NyxFoundation/FoldNTT/docs/README.md

# docs/ — paper materials

Write-up of the two verified inventions (`../verification/`), building
toward a submission. Produced phase-by-phase by an autonomous loop; every
claim traces to a CI-reproducible script.

| File | Contents |
|---|---|
| `paper-plan.md` | phase tracker + remaining-before-submission list |
| `related-work.md` | novelty sweep; adjusted claims C1–C3 |
| `lemmas.md` | the 4 lemmas with proofs + machine-check cross-refs |
| `evaluation.md` | system-sim results + synthesis cost table (PnR TODO) |
| `generalization.md` | Proth-prime generator; Falcon + Kyber instances |
| `algorithm-level.md` | where the ideas apply outside hardware; prime-selection guidance (with `generator/prime_scout.py`) |
| `scaling.md` | measured lane-array scaling: iso-chip parallelism, clock cost, the ceiling (with `fpga/scale_sweep.sh`) |
| `paper/paper.md` | full manuscript draft (section TODOs + refs inline) |
| `venue-assessment.md` | where-to-submit / what-level analysis |

Status: draft complete; open items in `paper-plan.md` → "Remaining before
submission" (background prose, bibliography, one prior-work diff, whole-core
PnR, artifact DOI, venue choice).
