NyxFoundation/FoldNTT/fpga/README.md

# Post-route Fmax: open flow (no Vivado)

Routed Fmax for the reference vs proposed multiplier and butterfly on
Artix-7 xc7a100t, using openXC7's `nextpnr-xilinx`. No Vivado, no
multi-GB AMD download.

## Tools: one command via the repo flake

```sh
nix develop        # from the repo root; sets NP + CHIPDB (xc7a100t) + yosys
fpga/fmax.sh          # then the scripts run with no arguments
fpga/fmax_core.sh
```

The repo `flake.nix` pins openXC7 tag `0.8.2` (HEAD's flake currently
fails to evaluate: `nextpnr-xilinx` is missing from its nixpkgs binding; `0.8.2`
has a self-consistent `flake.lock`) and wires `NP`/`CHIPDB`/`YOSYS` into the
devShell. First entry builds the Artix-7 chipdb from prjxray-db (~10-20 min,
heavy pypy pass); it is then cached in the nix store.

Manual (no flake) equivalent:

```sh
nix build github:openXC7/toolchain-nix/0.8.2#packages.x86_64-linux.nextpnr-xilinx
nix build github:openXC7/toolchain-nix/0.8.2#packages.x86_64-linux.nextpnr-xilinx-chipdb.artix7
export NP=<result-nextpnr>/bin/nextpnr-xilinx CHIPDB=<result-chipdb>/xc7a100tcsg324.bin YOSYS=yosys
```

## Method

Each module is register-wrapped (`wrap.py`): every DUT input is driven
from an internal shift register and every output is registered then
XOR-reduced, so the only I/O is `clk` + `serial_in` + `serial_out`. This
(a) makes the timed path a true register-to-register critical path, and
(b) avoids the wide-module I/O-placement failures nextpnr hits when 40-80
ports must be pinned. Reported = best of 3 placer seeds.

## Result (interpretation in ../../docs/evaluation.md)

| module | Fmax (xc7a100t) |
|---|---|
| `modular_mul` (Barrett, 3 DSP) | ~233 MHz |
| `modular_mul_kred` (K-RED, 1 DSP) | ~230 MHz |
| `compact_bf` (reference, INTT-buggy) | ~164 MHz |
| `compact_bf_v2` (K-RED, INTT-correct) | ~122 MHz |

K-RED is Fmax-neutral at the multiplier (3→1 DSP for free), and the
butterfly trades ~26% clock for the DSP/memory savings, partly the cost of
correctness: the reference omits the §3 halving. A pipelined K-RED/fold
recovers most of it at +1 latency.

## Whole-core Fmax (`fmax_core.sh`)

The same flow on the whole core (`top_poly_mul` vs `top_poly_mul_v2`, linked
against `fullcore/fsm_recon.v` to elaborate; static timing needs only the
netlist) gives ~137 vs ~136 MHz: the butterfly's −26% dilutes to ~1% at
the core, because the memory system / address generators / networks / FSM
(identical in both) dominate the critical path.

## Files
| File | Role |
|---|---|
| `fmax.sh` | per-module Fmax comparison (best of 3 seeds) |
| `fmax_core.sh` | whole-core Fmax (reference vs proposed top) |
| `wrap.py` | register-wrapper generator (reduces a module to clk + 2 pins) |
