NyxFoundation/FoldNTT/docs/evaluation.md

# Evaluation (Phase 3–4)

## §sim: system-level RTL simulation (DONE)

`verification/fullcore/run_stream.py` drives the invented RTL (the
register-level hardware source code:
`compact_bf_v2` + `modular_mul_kred` + `tf_rom_fold`) through a full N=1024
NTT and INTT under iverilog. On every tested vector, the RTL `NTT(x)` equals
the reference `DIT_NR_NTT` on the real twiddle table (the precomputed
constants the transform multiplies by), and
`INTT(NTT(x)) == x` exactly. The issue-#7 halving fix and the 9⁻¹-scaled
folded ROM therefore compose into a correct transform at the system level,
not merely per butterfly (the transform's small multiply-and-add step).

This closes the gap the module proofs leave. fv_bf_v2 proves the butterfly
matches the spec for every input; `run_stream.py` shows that the specced
modules, sequenced by a controller and fed by the folded ROM, realize the
whole transform on real gates (iverilog).

The banked memory system is covered too: the released `fsm.v` is empty
(upstream #4), so `verification/fullcore/fsm_recon.v` reconstructs a
controller from the shipped datapath's timing, and `run_sim.py` drives the
whole `top_poly_mul` (reference and v2) through NTT then INTT on five
vectors. The reference core returns `NTT(x)` exactly and `INTT(NTT(x)) =
2¹⁰·x` (issue #7 at full-core RTL); the v2 core round-trips exactly; both
take 5290 cycles per 1024-point transform, data-independent. The controller
is consistent with the released datapath but is not the authors' original.
See `verification/fullcore/README.md`.

## §synth: synthesis cost (DONE, generic; PnR pending)

All numbers come from `yosys` generic synthesis (`synth -flatten -noabc`),
reproducible via `kred-butterfly/cost_report.ys` and the ROM comparison. Cell
counts are technology-independent gate counts, not LUTs (the FPGA's
logic cells).

| Block | reference | proposed | Δ |
|---|---|---|---|
| modular multiplier | `modular_mul.v` 2176 cells, 101 FF, **3 mults** | `modular_mul_kred.v` 1724 cells, 74 FF, **1 mult** | −21% cells, −27% FF, −67% mults |
| butterfly | `compact_bf.v` 2820 cells, 297 FF, 3 mults | `compact_bf_v2.v` 2549 cells, 270 FF, 1 mult | −10% cells (**and INTT-correct**) |
| twiddle ROM | `tf_ROM.v` 7828 cells, 14322 stored bits | `tf_rom_fold.v` 1611 cells, 7168 stored bits | −79% cells, −50% bits |

These generic counts are directionally useful, but they overstate the FPGA
benefit for the ROM, which maps to distributed LUT-RAM rather than gates.
For the ROM, the paper relies on the FPGA-primitive numbers below, not the
generic counts.

### FPGA primitives (open flow: `yosys synth_xilinx`, xc7 target)

The generic gate counts overstate the FPGA story in two ways; mapping to
real 7-series primitives resolves both. Per module, flattened
(reproduce: `nix shell nixpkgs#yosys --command fpga/fpga_cost.sh`):

| module | LUT | FF | **DSP48** | CARRY4 |
|---|---|---|---|---|
| `modular_mul` (Barrett) | 29 | 101 | **3** | 8 |
| `modular_mul_kred` | 83 | 74 | **1** | 14 |
| `compact_bf` (ref) | 158 | 297 | **3** | 24 |
| `compact_bf_v2` | 231 | 270 | **1** | 46 |
| `tf_ROM` | 241 | 14 | 0 | 0 |
| `tf_rom_fold` | 192 | 15 | 0 | 18 |

Reading, and why the per-FPGA numbers matter:

1. DSP (the FPGA's dedicated multiplier blocks) 3 → 1 holds on real
   primitives: −67% DSP per butterfly and −27% FF (register cells)
   on the multiplier. NTT accelerators are almost always DSP-bound, since
   many parallel butterflies compete for the scarce DSP blocks. This is the
   saving that matters, and it scales ×d.
2. K-RED trades DSPs for LUT/carry logic. The multiplier's LUTs go
   29 → 83, the butterfly's 158 → 231; the shift-add folds are LUT+CARRY4.
   On a LUT-bound design the trade could be neutral-to-negative; on the
   usual DSP-bound design it is a clear win. We report both directions.
3. The ROM's −79% was generic gates, not FPGA. Mapped to primitives, the
   ROM stays in distributed LUT-RAM (yosys does not infer BRAM — an
   on-chip memory block — for
   1023×14 here), so `tf_rom_fold` is only −20% LUT (241 → 192), with
   fold7 adding CARRY4. The defensible ROM claim is the −50% stored bits,
   which converts to a BRAM saving only when the table is large enough to
   be BRAM-mapped (bigger N, or a forced `ram_style="block"`); at Falcon's
   N=1024 as distributed ROM the LUT win is real but small. The paper is
   corrected accordingly.

### Whole-core area (open flow, `fpga/fpga_cost_core.sh`)

Synthesizing the whole core (one butterfly + two conflict-free banks + the
twiddle ROM + address generators + the reconstructed FSM), reference
`top_poly_mul` vs proposed `top_poly_mul_v2`, on 7-series primitives:

| core | LUT | FF | **DSP48** | RAMB18 | CARRY4 |
|---|---|---|---|---|---|
| reference | 784 | 580 | **3** | 2 | 106 |
| proposed | 819 | 500 | **1** | 2 | 138 |

The released `fsm.v` is empty, so the core is linked against
`fullcore/fsm_recon.v`, the reconstructed controller that `run_sim.py`
validates end-to-end (§sim); datapath leaf modules carry `keep` so DCE
doesn't strip the un-observed banks/mult/ROM, matching the RTL's
`DONT_TOUCH`.

Whole-core reading:

- DSP48 3 → 1: with a single butterfly, the per-butterfly saving is the
  whole-core saving, and with `d` parallel butterflies it scales ×d. This
  confirms the headline at the core level.
- FF −14% (582 → 502): the K-RED multiplier has fewer pipeline
  registers than Barrett (580→502 with the reconstructed FSM's pipe register).
- LUT +5% (784 → 824): the K-RED DSP→LUT trade (butterfly +73 LUT)
  slightly outweighs the folded ROM's LUT saving (−49) at the core level,
  diluted by the unchanged banks/AGU/FSM. Consistent with the per-module
  numbers.
- RAMB18 unchanged (2 = 2): the two RAMB18 are the two data banks. The
  twiddle ROM maps to distributed LUT-ROM in both cores, so the ψ-fold's
  −50% stored bits does not cut BRAM count at N=1024; it would only at a
  larger table or a forced block-RAM mapping. This confirms the ROM caveat
  above with a whole-core measurement.

### Timing proxy: logic depth (open flow, no PnR needed)

Fmax (the highest clock frequency the routed design sustains) needs PnR
(place and route: mapping the logic onto the chip's physical fabric), but
yosys' longest-topological-path (`ltp`) gives a
technology-mapped logic-depth proxy that already answers the paper's two
timing questions. Per module (post-`synth_xilinx`, LUT/carry levels):

| module | LTP (logic levels) |
|---|---|
| `modular_mul` (Barrett) | 17 |
| `modular_mul_kred` | 21 |
| `tf_ROM` | 7 |
| `tf_rom_fold` | 26 |

- K-RED vs Barrett (21 vs 17): the K-RED fold adder chains add ~4 levels
  of logic. But `modular_mul`'s DSP48 counts as ~1 level in this proxy while
  hiding a full multiply, so the comparison understates Barrett. Both units
  are latency-4 pipelined, so the per-stage path is what sets Fmax, and the
  K-RED stages are short adder chains. Directionally comparable; confirm with
  PnR.
- fold7 on the ROM path (26 vs 7): the derived-half read path is
  materially deeper than a plain ROM lookup. The ψ-fold's real cost is
  combinational depth on the upper-half read, not area. This is the risk the
  ROM change carries, and we already acted on it (below).

**Depth-driven redesign of fold7.** This analysis itself drove an RSI step.
The first fold7 used three chained conditional subtractions (−4q, −2q, −q),
LTP 31. Since `7x ∈ [0, 7q)`, we replaced them with six parallel constant
comparators that select `m·q` from precomputed multiples, followed by a
single subtraction: LTP 31 → 26, LUT 214 → 192, CARRY4 23 → 18, still
DSP-free. The new datapath was re-verified end-to-end: z3 (an automated theorem prover) `VERIFIED`, the
shipped-ROM equivalence miter (a circuit comparing the two
implementations output-for-output), the full-transform sim, and the mutation
sweep all pass. A pipelined fold7 (one extra register) would remove the
depth from the ROM read entirely at +1 latency; we keep the combinational
version to preserve the drop-in 1-cycle ROM interface, and flag the
depth/latency trade for PnR.

### Post-route Fmax (open flow, no Vivado): `fpga/fmax.sh`

Routed Fmax was obtained without Vivado, via openXC7's `nextpnr-xilinx`
(pin the working tag `github:openXC7/toolchain-nix/0.8.2`; HEAD's flake is
broken) with the artix7 chipdb, on xc7a100t. Each module is
register-wrapped (`fpga/wrap.py`: all inputs come from an internal shift
register, outputs are registered and XOR-reduced, so only clk + 2 pins are
I/O) to time the true register-to-register critical path; best of 3 placer
seeds:

| module | Fmax (xc7a100t, best of 3 seeds) |
|---|---|
| `modular_mul` (Barrett, 3 DSP) | 243 MHz |
| `modular_mul_kred` (K-RED, 1 DSP) | 232 MHz |
| `compact_bf` (reference — INTT-buggy) | 169 MHz |
| `compact_bf_v2` (K-RED, INTT-correct) | 123 MHz |

(Pinned toolchain: yosys 0.62 + openXC7 nextpnr-xilinx 0.8.2 via `nix
develop`; each seed's nextpnr log is archived under `fpga/reports/`.)

Reading; this is the number real PnR was needed for:

1. At the multiplier, K-RED costs about 4% Fmax vs Barrett (232 vs 243
   MHz, comparable to the seed spread). Dropping 3→1 DSP therefore costs
   little clock speed at the unit that matters for the DSP budget.
2. At the butterfly, the proposed core is slower (123 vs 169 MHz,
   −27%). Two plausible causes, not isolated by measurement: (a) the
   reference butterfly omits the per-stage `op21` halving (§3), so a
   correct reference would also pay for those gates. (b) The K-RED
   fold + fused-op21 logic lengthens the butterfly critical path vs a
   single DSP multiply.
3. Net: the ψ-fold/K-RED design trades DSP and twiddle storage for clock
   frequency at the butterfly. On a DSP- or memory-bound NTT accelerator
   that is the right trade; if the design is Fmax-bound, Barrett's DSP
   path is faster. We report the tradeoff, not a one-sided win.

**Whole-core Fmax** (`fpga/fmax_core.sh`, same RTL configuration as the
area measurement, with the validated reconstructed controller): reference
`top_poly_mul` 143.1 MHz vs proposed `top_poly_mul_v2` 137.5 MHz, best of
3 seeds (−4%). The seeds span 127–143 MHz (reference) and 130–138 MHz
(proposed), medians 136 vs 134 MHz, so the difference is inside the
seed-to-seed spread: read it as "a few percent at most". The butterfly's
−27% does not propagate to the core, consistent with the conflict-free
memory system, address generators, operand networks and FSM, all identical
in both cores, setting the critical path. At the level that actually
ships, the redesign delivers 3→1 DSP, −14% FF, the INTT bug fix and half
the twiddle storage at a few percent of Fmax.

A pipelined K-RED / fold7 (one extra register each) would recover much of
the butterfly Fmax at +1–2 cycles latency; a concrete follow-up. Vendor
(Vivado) numbers would confirm these open-flow figures but are not required
for the conclusion. Whole-core area and Fmax are measured on the
reconstructed controller that `run_sim.py` validates (see fullcore/README).
