NyxFoundation/FoldNTT/(commit log)

2026-07-02 feat(yosys): RTL-level formal verification — the 8 categories beyond datapath proofs
    SymbiYosys/yosys suite proving, directly on the released Verilog (no
    transcription):
    1. Pipeline timing: modular_mul == (a*b) mod q at latency 4 (BMC +
    k-induction); compact_bf == the DIT/DIF butterfly at latency 6, both
    modes, verified COMPOSITIONALLY — leaf units are proven equivalent to
    behavioural models (fv_units, fv_modular_mul) and then abstracted, so
    the butterfly obligations close in seconds (assume-guarantee).
    2. Control FSM: blocked by the release (fsm.v empty) — recorded by audit.
    3. Memory-hazard static half: AGU/bank-map properties re-proven on the RTL.
    4. Reset (outputs clea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
    [abstract_units.v, audit.py, fv_agu.sv, fv_compact_bf.sv, fv_modular_mul.sv, fv_param_width.sv, fv_reset.sv, fv_units.sv]
2026-07-02 docs: refresh READMEs — CI badge, yosys suite summary, compositional naming
2026-07-02 feat(proposed): CFNTT-KRED — 1-multiplier, bug-fixed radix-2 butterfly
    Recursive view->implement->verify loop over the reference design yields a
    drop-in replacement (same ports, delay fabric, latencies):
    - modular_mul_kred.v: q = 3*2^12+1 is Proth, so 3*2^12 == -1 (mod q) and
    the 28-bit product reduces by two shift-add K-RED folds + one conditional
    subtraction — 1 hardware multiplier instead of Barrett's 3 (K-RED per
    Longa & Naehrig 2016, known in software for this q; the verified hardware
    fusion into CFNTT is the contribution).
    - The unit returns 9ab mod q; the ROM stores 9^-1-scaled twiddles so every
    butterfly multiply is exact. The INTT twiddle is derived from the SAME
    R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
    [abstract_units_v2.v, fv_bf_v2.sv, fv_kred.sv, kred_math.py]
2026-07-02 feat(proposed): compositional fv_kred (fold-spec golden) + docs
    The %-golden miter (RTL Barrett-style re-verification against a 32-bit
    divider) did not converge in the solver; restructured to the established
    compositional chain — sby proves RTL == the K-RED fold spec (structural,
    seconds, k-induction closes too), verify_kred.py's z3 proof pins the fold
    == 9c mod q over the full domain. Mutation probe re-run: a nudged fold
    constant in the RTL is caught with a counterexample.
2026-07-03 feat(proposed): psi-fold twiddle ROM — half the words, found by visual review
    Reviewing the 3D architecture model showed the 1023-word twiddle ROM as
    the largest remaining block after the KRED redesign, next to two visual
    precedents (shift-add folds are ~free; op21-on-ROM derives variants from
    stored words). The bit-reversed negacyclic layout satisfies
    w_rom[512+j] == 7*w_rom[j] (mod q) for all j (psi = kesai = 7), and
    x7 = (x<<3)-x is shift-sub: tf_rom_fold.v stores 512 (9^-1-scaled) words
    and derives the rest with fold7 (three conditional subtractions, no
    multiplier), same interface/latency as tf_ROM.v. Recursive: a 256-word
    ROM needs at most fold7 x3 (validated e2e).
    Verified: fold r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
    [fv_rom_fold.sv, gen_rom_fold.py, rom_fold_math.py]
2026-07-03 test(proposed): thorough yosys verification sweep for both inventions
    New coverage, all green in a fresh end-to-end run (proposed/run_all.sh):
    - fv_reset_v2: async reset forces the v2 butterfly outputs to 0 from ANY
    symbolic state, with the REAL leaf units (BMC + k-induction).
    - fv_rom_fold strengthened: REN is now FREE — load cycles prove
    9*Q_new == Q_ref (mod q) at every legal address, idle cycles prove BOTH
    ROMs hold their outputs, so equivalence survives arbitrary stall
    patterns. The A=1023 divergence (shipped ROM holds, fold ROM wraps) is
    documented and excluded by an assumption itself proven in yosys/fv_agu
    (tf_address_generator never emits 1023). k-induction omitted w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
    [fv_reset_v2.sv, fv_rom_fold.sv]
2026-07-03 feat(fullcore): system-level RTL simulation of the inventions (phase 3-4)
    proposed/fullcore/run_stream.py drives the real compact_bf_v2 +
    modular_mul_kred + tf_rom_fold through a full N=1024 NTT+INTT under
    iverilog (pipelined issue, index delay-line collect, full ROM pre-read):
    NTT == reference DIT_NR_NTT, INTT(NTT(x)) == x EXACTLY — the issue-#7 fix
    and the folded ROM compose into a correct transform at the system level.
    Added to CI.
    Honest scope: cfntt_ref's exact banked-memory FSM is not reproduced (the
    released fsm.v is empty, upstream #4). fsm_recon.v + top_poly_mul_v2.v
    drive the actual banked datapath but the reconstructed schedule is not yet
    cycle-accurate (X's before pipeline fi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
    [fsm_recon.v, run_sim.py, run_stream.py, tb_fullcore.v, tb_stream.v, top_poly_mul_v2.v]
2026-07-03 docs+artifact: background prose, FPGA-primitive numbers (honest), Vivado guide, container
    Phase '1' (background) and '5' (artifact) of the paper plan:
    - paper.md §2: real Background prose (negacyclic NTT, DIT-NR/DIF-RN
    butterflies, psi, and CFNTT's conflict-free 2-bank mapping + shared ROM);
    removed the [TODO].
    - FPGA-primitive cost via the open flow (proposed/fpga_cost.sh, yosys
    synth_xilinx): DSP 3->1 per butterfly and -27% FF CONFIRMED on real
    primitives. Reported honestly: K-RED trades DSP for LUT/carry logic, and
    the ROM's generic -79% is only -11% LUT as distributed LUT-RAM (the
    defensible ROM claim is -50% stored bits, a BRAM win only when
    BRAM-mapped). Corrected abs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
2026-07-03 docs: Compact-FALCON diff from the FULL paper (user-provided PDF)
    Read the actual Compact-FALCON 2025 paper (docs/refs/, gitignored — IEEE
    copyright). Correction: it has NO twiddle-compression mechanism (the
    earlier attribution was a search-summary error). It stores twiddles in
    FULL (two FP64 ROMs; the NTT path reuses them) and its only twiddle
    reduction is skipping the trivial first/last FFT stage; NTT modular
    reduction is Barrett (K-RED only cited in background). Target xc7a100t
    @134MHz, Vivado 2022.2.
    Net effect: STRENGTHENS novelty — even the most recent (2025) Falcon NTT
    accelerator uses full twiddle ROMs + Barrett, so neither the psi-fold nor
    the K-RED retrofit overlaps it. Up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
2026-07-03 docs(paper): Fig.1 datapath, fold7 pseudocode, positioning table
    - Sec 4: ASCII datapath figure of compact_bf_v2 (1 mult, the two op21
    bug-fix gates highlighted).
    - Sec 4.2: fold7 rewritten to the parallel-reduction pseudocode (6 parallel
    comparators + 1 subtraction), replacing the stale 3-chained-subtract text.
    - Sec 7: FPGA-primitive table updated to the redesigned fold7 (LUT 214->192)
    with a logic-depth column, and a NEW positioning table vs CFNTT and
    Compact-FALCON — both use Barrett + full twiddle ROMs, so neither of our
    contributions overlaps them. Honest framing: a Pareto move on DSP +
    twiddle-memory at equal function on a verified, bug-fixed drop-in; no
    head-to-head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
2026-07-03 ci: replace flaky setup-oss-cad-suite with retrying tarball fetch
    The YosysHQ/setup-oss-cad-suite@v3 action intermittently failed fetching
    its release tarball, flaking docs-only pushes (verify job stayed green, but
    yosys-formal went red on infra, not on our code — locally run_all.sh is
    fully green). Resolve the latest release tag via the GitHub API and fetch
    the tarball with curl --retry (5x, --retry-all-errors), source its
    environment for both the yosys/run_all.sh and proposed/run_all.sh steps.
2026-07-03 ci: don't source oss-cad-suite/environment (it clobbered uv's python)
    The retrying tarball install fixed the setup flake, but sourcing
    oss-cad-suite/environment set LD_LIBRARY_PATH to its bundled libs, which
    hid uv's managed libpython3.11.so.1.0 -> proposed/run_all.sh's 'uv run'
    died with exit 127. oss-cad-suite's bin/ launchers are self-wrapping, so
    adding bin to PATH (already done via GITHUB_PATH) is enough for yosys/sby/
    yices without the environment munging that breaks uv.
2026-07-03 docs: honest venue assessment + submission strategy
    Candid read: the technical primitives (K-RED, half-twiddle-ROM) are mostly
    known art; the real edge is functional verification of a published
    accelerator + a real bug find + a verified drop-in redesign, all
    CI-reproducible.
    Current level = workshop/preprint. Best-fit submittable-now target =
    FMCAD Applications track / DATE verification (lead with verify->bug->
    redesign). Hardware-design framing (DATE/ICCAD, and only then TCHES) needs
    Vivado PnR + SOTA comparison first. Agentic-discovery angle = separate
    workshop paper with a visual-vs-code ablation. Explicitly advises NOT
    targeting TCHES/CHES with the current content.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
2026-07-03 docs(paper): deepen Sec 3 (the bug) + verify-don't-test framing
    Aligning the paper with the honest best-fit venue (FMCAD/DATE case study,
    per venue-assessment.md): the verification-and-bug-find story is the edge,
    so lead with it.
    - Sec 3 rewritten in full: the defect (per-stage 1/2 omitted in radix-2
    compact_bf; modular_half shipped but never instantiated; radix-4 PEs do
    instantiate it), the exact 2^10 consequence and why it's a clean global
    constant, why the assertion-free shipped testbench missed it, how the
    round-trip check surfaced it and full-core RTL confirmed it, and why the
    K-RED redesign fixes it for free (shared op21).
    - Sec 1: an explicit 'verify, don't just test' frami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
2026-07-03 feat: whole-core FPGA-primitive area (open flow) — DSP 3->1 at core level
    Key realization: whole-core AREA doesn't need Vivado — only Fmax does.
    synth_xilinx elaborates and maps the full core when linked against the
    reconstructed fsm_recon.v (area-only; not the cycle-accurate schedule), with
    keep on the datapath leaf modules so DCE doesn't strip the un-observed
    banks/mult/ROM (matching the RTL's DONT_TOUCH).
    proposed/fpga_cost_core.sh (CI-run): reference top_poly_mul vs proposed
    top_poly_mul_v2 on 7-series primitives:
    reference LUT 784 FF 580 DSP 3 RAMB18 2
    proposed LUT 824 FF 500 DSP 1 RAMB18 2
    Honest whole-core reading (evaluation.md, paper Sec 7): DSP 3->1 (scales
    xd wi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
2026-07-03 fix(fullcore): FSM write-latency 8->10 removes X-corruption; diagnosis recorded
    Cycle-accurate tracing of the reconstructed banked full-core: the datapath
    write-back latency is 10 (read path 4 + butterfly 6), not 8. Fixing wen to
    pipe[9] eliminates the earlier X-corruption (writes no longer fire before
    the pipeline fills). The result is now well-defined but still numerically
    wrong, so the schedule is not yet cycle-accurate — the remaining gap is the
    precise alignment of the twiddle ROM read and the shift_7-delayed
    operand/output networks vs the bank read/write across per-k twiddle changes.
    Recorded precisely in fullcore/README.
    This is not on the inventions' critical path (streaming har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
    [fsm_recon.v]
2026-07-03 feat: whole-core Fmax (open flow) — butterfly -26% dilutes to ~1% at the core
    Closing the last hardware gap: whole-core post-route Fmax on xc7a100t
    (proposed/pnr/fmax_core.sh), same elaborating core as the area numbers
    (static timing needs only the netlist):
    top_poly_mul (reference) ~137 MHz
    top_poly_mul_v2 (proposed) ~136 MHz -> -1%
    The isolated butterfly's -26% does NOT propagate to the core: the
    conflict-free memory system, address generators, operand networks and FSM
    (identical in both) dominate the whole-core critical path, so the butterfly
    is only a fraction of it. Net, honest, whole-core result: the shipped core
    gets 3->1 DSP, -14% FF, the INTT bug fix and -50% twid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
2026-07-03 docs: update venue assessment — open-flow PnR obtained upgrades the HW-paper route
    The measured area + post-route Fmax (openXC7 nextpnr, xc7a100t) change the
    venue calculus: the 'Hardware design paper' framing moved from 'needs PnR'
    to 'now viable' — the shipped core gets 3->1 DSP + INTT bug fix + -50%
    twiddle bits at ~1% whole-core Fmax cost (the butterfly's -26% dilutes to
    ~1%). Two honest routes now open: the safest FMCAD/DATE formal-methods
    case study (measured HW is now supporting evidence, not a gap), and a
    now-viable DATE/ICCAD hardware paper (needs a SOTA throughput comparison
    before submission; Vivado confirmation optional). TCHES still needs vendor
    numbers + sharper novelty.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
2026-07-03 docs(paper): intro reflects the completed measured evaluation
    The contributions summary said only '\S7 reports costs' — written before the
    open-flow numbers existed. Now states the headline measured result up front:
    3->1 DSP + half twiddle storage at ~1% whole-core Fmax cost (-21% ENS), bug
    fixed, no Vivado. Keeps the verify-don't-test framing as the primary
    contribution; the measured payoff now appears where a reader looks for it.
2026-07-03 feat(paper): Fig.1 as a TikZ vector figure (renders in both builds)
    Replaced the ASCII/box-drawing datapath diagram with a proper TikZ figure,
    embedded in paper.md as a gfm+raw_attribute {=latex} raw block — a
    both-column-spanning figure* wrapped in resizebox, so it renders in BOTH the
    single-column paper.pdf and the two-column IEEE build. The old ASCII art
    could not fit a 3.5in IEEE column (~600pt overfull); the vector figure spans
    both columns cleanly and reads like a real paper.
    The datapath shows: u/v/w through DFFs; v->mux(sel)->modular_mul (K-RED,
    shaded); w->modular_half (shaded, the fused op21); product + u feeding
    modular_add and modular_sub; op21 (shaded) on the add path; bf_lo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
2026-07-04 feat: repo flake — one-command Vivado-free FPGA flow (openXC7 pinned)
    Adds flake.nix + flake.lock providing a devShell that pins openXC7 tag 0.8.2
    (HEAD's flake fails to evaluate) and wires NP/CHIPDB (Artix-7 xc7a100t) +
    yosys, so the FPGA scripts run with no arguments:
    nix develop
    proposed/pnr/fmax.sh # per-module post-route Fmax
    proposed/pnr/fmax_core.sh # whole-core post-route Fmax
    Verified end-to-end: 'nix develop' resolves NP/CHIPDB to the cached store
    paths and fmax.sh reproduces the numbers (modular_mul ~243 / kred ~232 MHz)
    with no manual setup. Also exposes packages.{nextpnr-xilinx,artix7-chipdb}
    for scripting/CI. This locks the paper's Fmax-reproduction toolcha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
2026-07-04 docs(paper): reflect the repo flake in the Reproducibility section
    The Reproducibility section described the manual openXC7 tag pin but predated
    the repo flake.nix. Now states the actual one-command entry: a repo
    flake.nix pins the whole toolchain (incl. the exact openXC7 tag) so
    'nix develop' gives a shell where run_all.sh / fpga_cost*.sh / pnr/fmax*.sh
    all run with no setup, and the Fmax bullet notes flake exports NP/CHIPDB for
    argument-free runs. Both builds still clean (single-col 9pp; IEEE zero
    errors/overfulls).
2026-07-04 test(newcore): NTT cross-validation vs golden streaming + reproducible driver
    Adds newcore/run_check.py: two independent iverilog checks, exit 0 iff both
    pass —
    1. whole-core ROUND-TRIP: INTT(NTT(x)) == x (own-FSM banked core)
    2. NTT CROSS-VALIDATION: the new core's post-NTT memory is BIT-IDENTICAL to
    the golden streaming harness (tb_stream.v) on the same input (1024/1024)
    So the core computes the *correct* NTT (matches the golden-validated result),
    not merely an invertible transform. tb_ntt_core.v now also publishes its
    input and post-NTT memory so the golden harness can be run on the same
    vector. Hex artifacts gitignored.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
    [run_check.py, tb_ntt_core.v]
2026-07-04 feat(newcore): Basys 3 on-board self-test wrapper + XDC
    basys3_ntt_selftest.v: a self-checking top for the Digilent Basys 3
    (xc7a35tcpg236). No host PC — on power-up it generates x[i]=(i*7+1) mod q,
    loads ntt_core, runs NTT then INTT, reads back and checks INTT(NTT(x))==x
    entirely on-chip, and shows the verdict on the LEDs:
    led0=done, led1=PASS, led2=FAIL, led[15:6]=mismatch count, led[5:3]=phase.
    Re-runs on btnC.
    Simulated (tb): done=1, PASS=1, FAIL=0, miss=0 -> BASYS3 SELFTEST SIM: PASS.
    basys3.xdc pins clk (W5, 100 MHz), the 16 LEDs and btnC per the Digilent
    master constraints. Ready to synthesize to a bitstream (openXC7, next) and
    load when the board arrives.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
    [basys3.xdc, basys3_ntt_selftest.v]
2026-07-04 feat(newcore): Vivado-free Basys 3 bitstream — full open flow works end-to-end
    Completes the on-board demo path with ZERO Vivado:
    yosys synth_xilinx -> openXC7 nextpnr-xilinx (place & route) -> FASM ->
    prjxray fasm2frames -> xc7frames2bit -> design.bit
    - newcore/bit.sh: the reproducible flow (pins openXC7 0.8.2, resolves the
    chipdb + prjxray-db + fasm python env via nix). Produces a valid 2.19 MB
    Xilinx bitstream for xc7a35tcpg236-1.
    - Timing: the self-test now runs the core on a /2 BUFG clock (50 MHz); the
    core clock closes at ~102 MHz post-route, so 50 MHz has 2x margin (the raw
    100 MHz was ~95 MHz, just under).
    - sim_prims.v: a BUFG stub so the wrapper simulates under iver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
    [basys3_ntt_selftest.v, sim_prims.v, tb_selftest.v]
2026-07-04 refactor: reorganize as FoldNTT — a folder per invention
    Reframes the repo identity from 'z3 verification of CFNTT' to FoldNTT: a new,
    formally-verified, DSP-minimal NTT accelerator (the name: both ideas *fold* —
    K-RED folds reduction into shift-adds, psi folds the twiddle ROM in half).
    New top-level layout, one folder per invention/concern:
    kred-butterfly/ (was proposed/kred) 1-mult K-RED butterfly + proofs
    psi-fold-rom/ (was proposed/rom-fold) half-storage twiddle ROM + proofs
    ntt-core/ (was newcore) own-FSM banked core + Basys 3 demo
    generator/ (was proposed/generator) any Proth prime (Falcon + Kyber)
    fpga/ (was proposed/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
2026-07-04 fix(reorg): two path refs missed by the string-based fixups
    Both used os.path.join(HERE, '..', ...) which the literal-string path fixer
    didn't catch:
    - verification/fullcore/run_stream.py + run_sim.py: the K-RED/psi-fold RTL
    moved to top level, so HERE/../kred -> HERE/../../kred-butterfly and
    HERE/../rom-fold -> HERE/../../psi-fold-rom (cfntt_ref '../../' unchanged).
    Re-run: STREAM SIM PASS.
    - verification/reference-fv/audit.py: HERE/../cfntt_ref -> HERE/../../cfntt_ref
    (reference-fv is one level deeper than the old yosys/). Re-run:
    ALL YOSYS CHECKS PASS.
    Both were the CI failures on the FoldNTT reorg; revalidated locally.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
    [audit.py, run_sim.py, run_stream.py]
2026-07-04 chore: FoldNTT rebrand — Docker image name + artifact.md
    Renames the reproducible-artifact Docker image ntt-fpga-z3 -> foldntt and the
    clone-dir references in docs/artifact.md, completing the rename.
2026-07-04 docs(readme): add the 3D floor-plan thumbnail at the top
    Puts the architecture's 3D model render (docs/assets/foldntt-arch-3d.png,
    from the visually-3d gallery scene) as a centered hero image at the top of
    the README, with a caption tying it to the paper's provenance — the ψ-fold
    ROM was first spotted while visually reviewing this 3D floor-plan.
2026-07-04 docs(readme): refresh the 3D model to the latest FoldNTT architecture
    Regenerated the top-of-README 3D floor-plan (via visually-3d: generate +
    self-improve, 94/100) so it reflects the DSP-MINIMAL FoldNTT design — one
    bright DSP (the single K-RED multiplier), a half-size psi-fold ROM, one
    BRAM, and the own-FSM core — instead of the old multi-DSP CFNTT board.
    Updated the caption accordingly.
2026-07-04 docs(readme): use the richer visualize-pipeline 3D model
    Swaps the sparse single-shot thumbnail for the full evidence-grounded model
    (90 parts, from 'visually visualize'): interleaved BRAM banks, the K-RED
    multiplier array, an exploded butterfly unit and the control/verification
    blocks — matching the visually-3d gallery's richness. Caption updated to
    the K-RED multipliers (1 DSP each, not 3) + the half-size psi-fold ROM.
2026-07-04 fix(ntt-core): revive the dead cross-validation and make it stale-proof
    The b2d7113 reorg renamed newcore/ -> ntt-core/ but the testbench kept
    dumping to $fopen("newcore/..."), which silently returns 0 after the
    rename: every dump was discarded and run_check.py's 'cross-validation
    PASS' compared two stale committed hex files against each other. CI
    stayed green while proving nothing about the simulated core.
    - tb_ntt_core.v: dump to ntt-core/, and a failed $fopen is $fatal —
    a silent dump failure can never pass again (probe-tested: restoring
    the old path now fails the suite).
    - tb_ntt_core.v: 4 round-trip vectors (ramp + seeded LCG random) run
    back-to-back, plus 2 INTT-only vectors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
    [ntt_core.v, run_check.py, tb_ntt_core.v]
2026-07-04 feat(fv): domain-faithful abstractions + NTT mutation probe + sweep hygiene
    Closes the two manual seams the FV audit flagged:
    - abstract_units_v2.v: each behavioural leaf model now returns an
    unconstrained $anyseq value whenever an operand is outside the domain
    its RTL proof justifies (< q). The composite butterfly proofs still
    PASS, which means the solver — not a hand argument — now discharges
    'no leaf in the asserted cone ever sees an unreduced operand'. A
    future edit that feeds an unreduced intermediate into a leaf turns
    into a counterexample instead of a silently unsound abstraction.
    - mutation_rtl.sh: M6 corrupts the NTT-side sub operand mux (fv_bf_v2_ntt
    had zero m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
2026-07-05 docs(paper): refresh to the hardened artifact + peer-review fixes
    Content refresh (the draft predated the production-hardening pass):
    - §5: domain-faithful abstractions (solver-discharged assume-guarantee
    seams), the own-FSM k-induction control proof with the twiddle
    closed forms, 8-mutation non-vacuity (was 5), the freshness-enforced
    own-core system checks; Table 1 gains the control-safety, host-load
    and own-core golden rows.
    - §7: 'A complete own-FSM core, through to a bitstream' — 1 DSP48 +
    1 RAMB18 on xc7a35t, 70-95 MHz, timing-gated build; positioning
    table gains the own-FSM row (the design point that actually runs).
    - §9 rewritten: functional whole-core gap closed; hon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
    [ntt_core.v, run_check.py, tb_ntt_core.v]
2026-07-05 docs: rewrite all prose for a plain human register
    One editorial pass over the paper, all READMEs and docs/. No numbers,
    claims, qualifiers, links, commands, tables or code blocks changed
    (verified: numeric-token multisets identical per file, code fences and
    link targets byte-identical, both paper builds clean).
    What changed, uniformly:
    - em-dash chains -> ordinary punctuation (paper: 73 -> 7, the rest of
    the tree: prose now dash-free; survivors sit in table cells, code
    comments and the Figure 1 LaTeX block)
    - emphatic mid-sentence bold and rhetorical italics removed; bold now
    marks term introductions, table cells and status leads only
    - 'honest(ly)' framing (20+ uses), ALL-CAPS empha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
2026-07-05 docs(readme): Results leads with the performance chart
    The DSP / twiddle-ROM / Fmax bullets become one dark-theme bar chart
    (docs/assets/results-summary.png, same data as the paper's Fig. 3,
    normalized to the reference core), matching the README's other visuals.
    The chart's TikZ source is committed next to it with rebuild
    instructions. Bullets that don't chart — correctness, open toolchain,
    license — stay.
2026-07-05 docs: algorithm-level implications note + prime scout
    docs/algorithm-level.md records where the two identities pay outside
    hardware — deliberately kept out of the paper's claim set: embedded
    cores, masked implementations (linear-vs-quadratic masking cost),
    GPU FHE twiddle-table bandwidth, and the Goldilocks connection — and
    distills the fold-economics boundary into a parameter-selection
    criterion (signed-digit weight of k <= 2; check for a shift-friendly
    psi).
    generator/prime_scout.py makes the criterion executable: enumerates
    Proth primes with k = 2^a +/- 1 across 14-16 / 28-32 / 60-64 bit
    windows (deterministic Miller-Rabin), reports the planner's fold count
    and the smallest shift-fri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
2026-07-06 docs: measured scaling study — lane arrays, iso-chip budgets, clock cost
    docs/scaling.md answers 'what does parallel instantiation buy?' with
    measurements from a new probe, fpga/scale_sweep.sh (butterfly lane
    arrays, each lane with its own twiddle ROM, register-wrapped like
    fmax.sh with a two-stage XOR reduce so the harness never owns the
    critical path).
    Measured:
    - Area is linear d=16..240 and K-RED's LUT premium is ~zero: a kred
    lane (butterfly + psi-fold ROM) is a few percent CHEAPER in LUTs than
    a ref lane (Barrett + full ROM) at one third the DSPs — the psi-fold
    ROM pays for the K-RED adders. The remaining trade is ~7x CARRY4.
    - At equal lane count the clock gap is small: ref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
2026-07-06 docs(scaling): complete the Fmax curve — congestion knee and the DSP wall
    Final measured points for the lane-array probe:
    - kred d=96 (63% LUT): 55.9 MHz — the congestion curve has a knee
    between 43% and 63% utilization (69.2 -> 67.8 -> 55.9 MHz), not the
    graceful slope the first two points suggested; corrected in the text.
    - kred d=128 (83% LUT): placer made no progress in 4 h — recorded as
    the probe's utilization ceiling in the open flow.
    - Iso-chip paragraph now brackets the answer honestly: within the open
    flow the measured best points give kred ~2.3x transforms/s over ref
    (placeability-driven: ref's 80%-DSP build never places, kred's DSP
    wall sits at 3x the lane count)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
2026-09-06 Reconstructed CFNTT controller validated end-to-end; paper revised for arXiv
    Controller (verification/fullcore):
    - fsm_recon.v: write enable at issue+8 (pipe[7]); in the shipped datapath
    the shift_7-delayed write address, write-side bank select and the
    butterfly output all belong to the issue eight cycles earlier. pipe[9]
    skipped each stage's first two writes and wrote back a phantom (0, 2^p)
    butterfly at the end of every stage. Document the schedule, the
    harmless trailing read, and the conf-hold contract (the shipped
    tf_address_generator decodes conf live).
    - tb_fullcore.v: all testbench actions on negedges. The $readmemh preload
    in a posedge time step raced data_bank's per-cy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
    [fsm_recon.v, run_sim.py, tb_fullcore.v]
